maximovev/radio-86rk-sdcard/radio-86rk-SRAM-sdcard-b.png

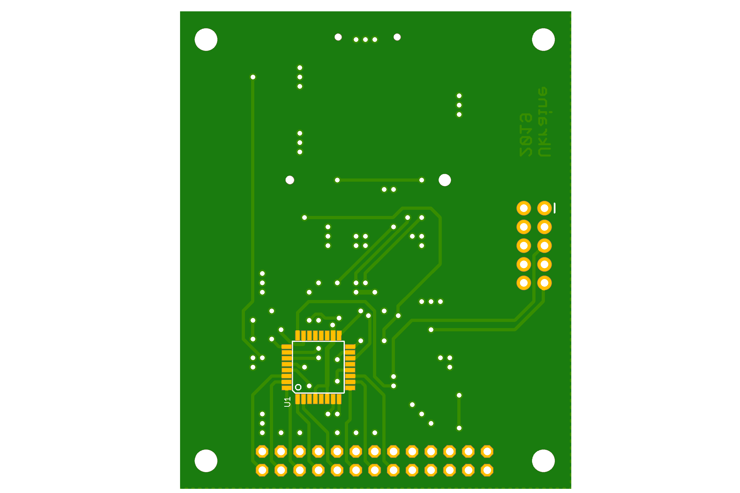
radio-86rk-SRAM-sdcard-b.png
