maximovev/radio-86rk-sdcard/radio-86rk-SRAM-sdcard.png

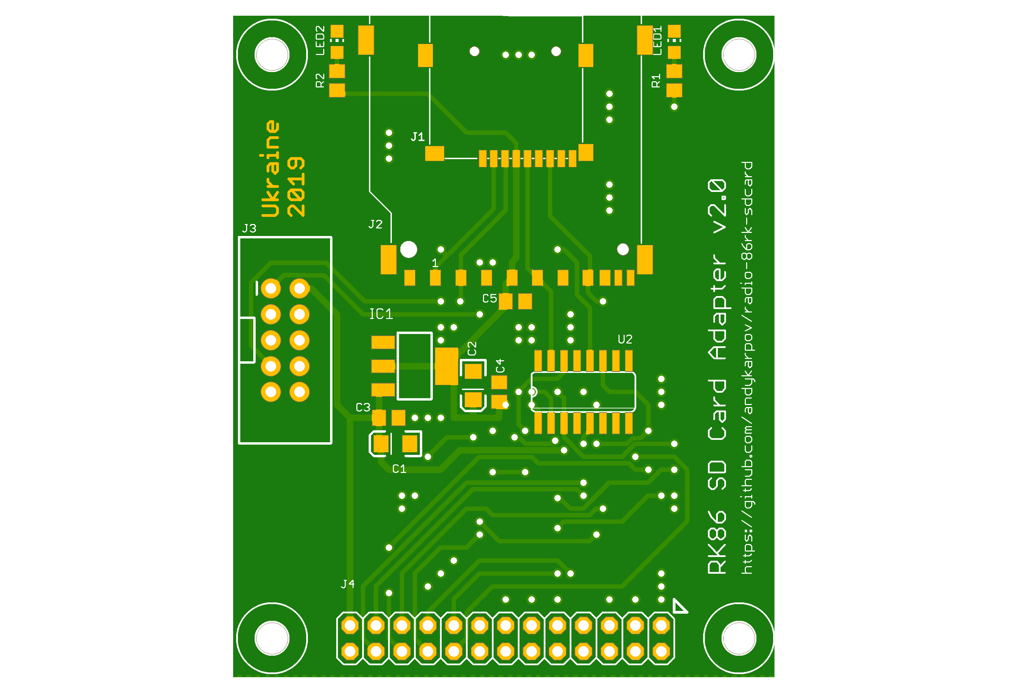
radio-86rk-SRAM-sdcard.png
