maximovev/radio-86rk-sdcard/hw/rk86_sd/rk86_sd.kicad_pcb

## KiCad design hw/rk86_sd/rk86_sd.kicad_pcb (2026-07-14)

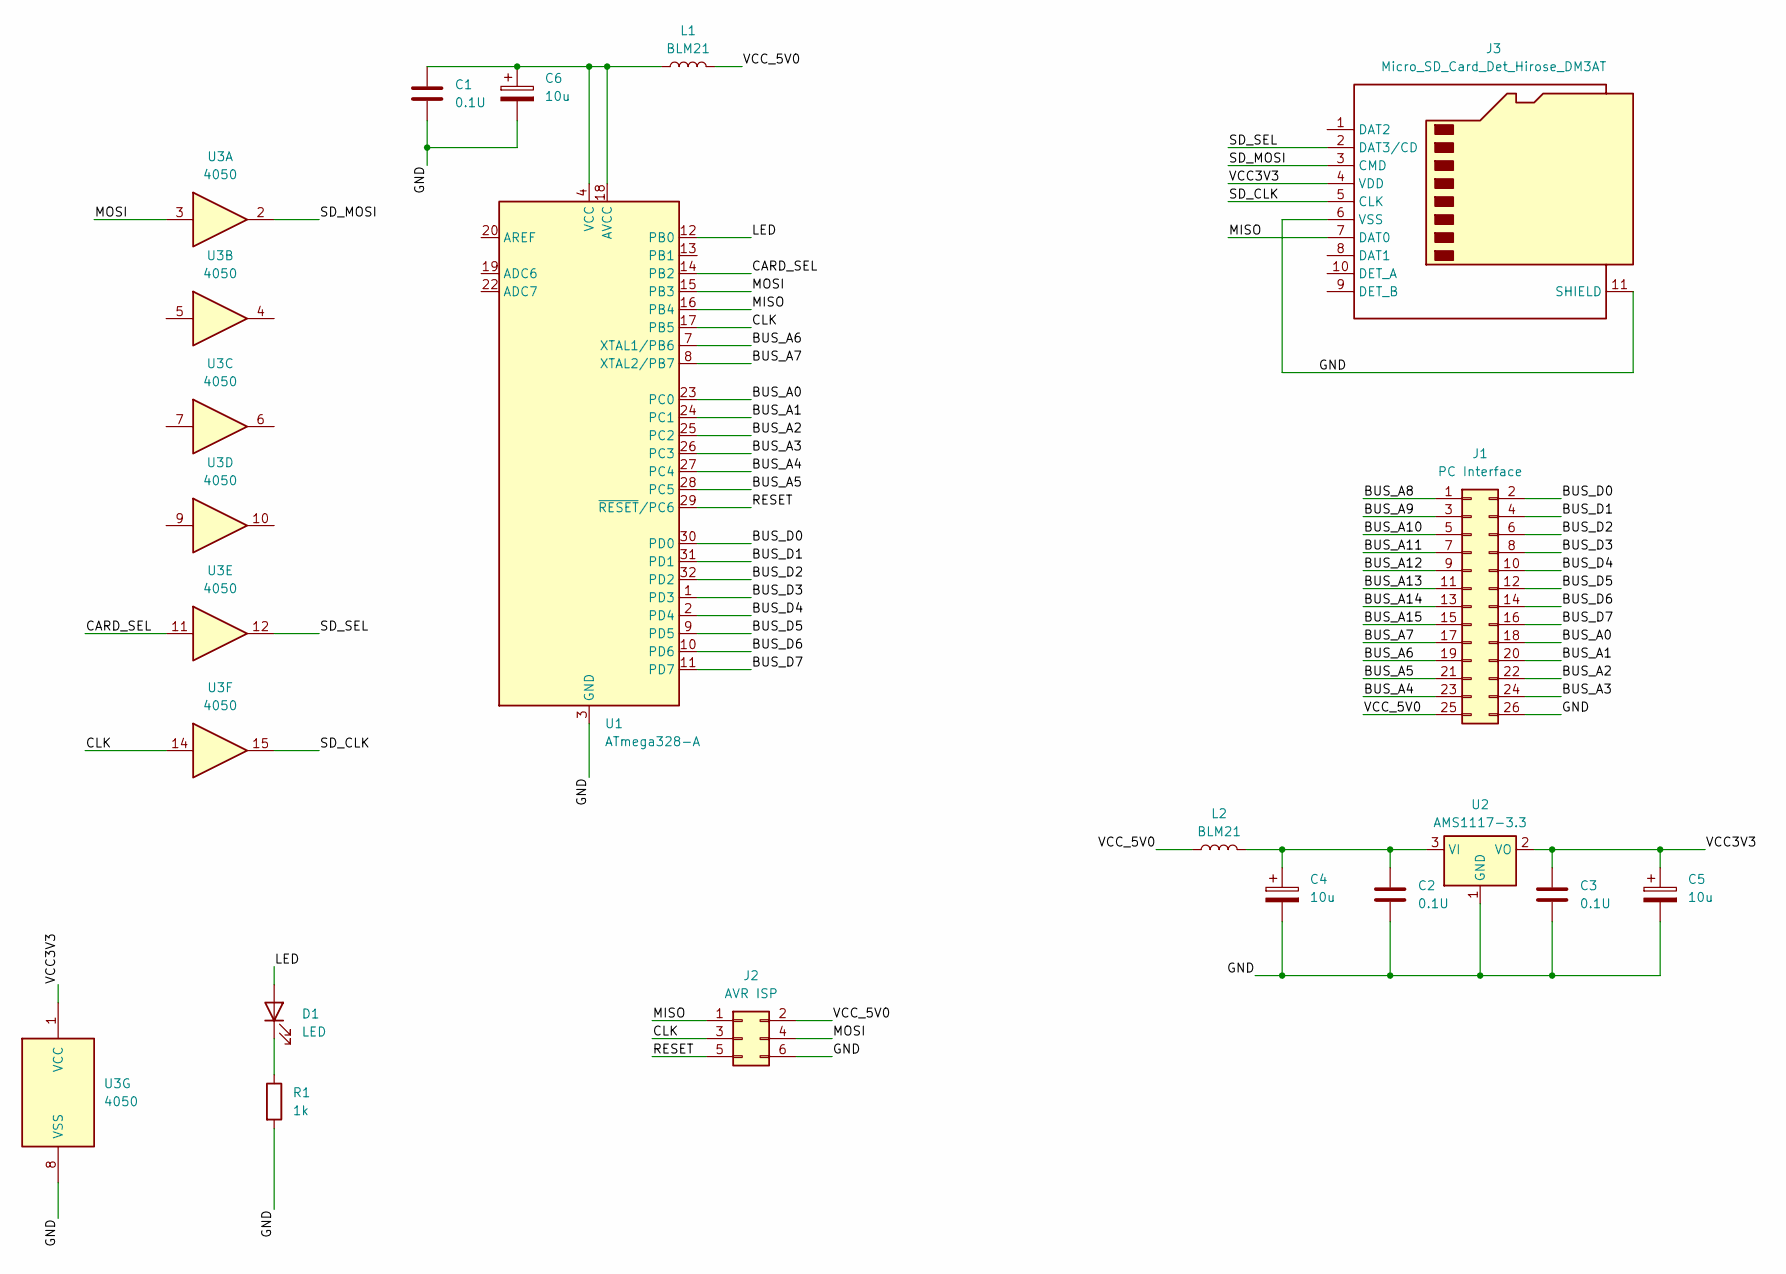
[picture p3: schematic rk86_sd.kicad_sch]

Parts:
C1, C2, C3: 0.1U; C_0805_2012Metric_Pad1.18x1.45mm_HandSolder
C4, C5, C6: 10u; CP_EIA-3528-21_Kemet-B_Pad1.50x2.35mm_HandSolder
D1: LED; LED_0805_2012Metric_Pad1.15x1.40mm_HandSolder
J1: PC Interface; IDC-Header_2x13_P2.54mm_Vertical
J2: AVR ISP; PinHeader_2x03_P2.54mm_Vertical
J3: Micro_SD_Card_Det_Hirose_DM3AT; microSD_HC_Hirose_DM3BT-DSF-PEJS
L1, L2: BLM21; L_0805_2012Metric_Pad1.15x1.40mm_HandSolder
R1: 1k; R_0805_2012Metric_Pad1.20x1.40mm_HandSolder
U1: ATmega328-A; TQFP-32_7x7mm_P0.8mm
U2: AMS1117-3.3; SOT-223-3_TabPin2
U3: 4050; SOIC-16_3.9x9.9mm_P1.27mm

Connections:
/BUS_A0: J1.18, U1.23 (PC0)
/BUS_A1: J1.20, U1.24 (PC1)
/BUS_A2: J1.22, U1.25 (PC2)
/BUS_A3: J1.24, U1.26 (PC3)
/BUS_A4: J1.23, U1.27 (PC4)
/BUS_A5: J1.21, U1.28 (PC5)
/BUS_A6: J1.19, U1.7 (XTAL1/PB6)
/BUS_A7: J1.17, U1.8 (XTAL2/PB7)
/BUS_A8: J1.1
/BUS_A9: J1.3
/BUS_A10: J1.5
/BUS_A11: J1.7
/BUS_A12: J1.9
/BUS_A13: J1.11
/BUS_A14: J1.13
/BUS_A15: J1.15
/BUS_D0: J1.2, U1.30 (PD0)
/BUS_D1: J1.4, U1.31 (PD1)
/BUS_D2: J1.6, U1.32 (PD2)
/BUS_D3: J1.8, U1.1 (PD3)
/BUS_D4: J1.10, U1.2 (PD4)
/BUS_D5: J1.12, U1.9 (PD5)
/BUS_D6: J1.14, U1.10 (PD6)
/BUS_D7: J1.16, U1.11 (PD7)
/CARD_SEL: U1.14 (PB2), U3.11
/CLK: J2.3, U1.17 (PB5), U3.14
/GND: C1.2, C2.2, C3.2, C4.2, C5.2, C6.2, J1.26, J2.6, J3.6 (VSS), J3.11 (SHIELD), R1.2, U1.3 (GND), U1.5 (GND), U1.21 (GND), U2.1 (GND), U3.8 (VSS)
/LED: D1.2 (A), U1.12 (PB0)
/MISO: J2.1, J3.7 (DAT0), U1.16 (PB4)
/MOSI: J2.4, U1.15 (PB3), U3.3
/RESET: J2.5, U1.29 (~RESET/PC6)
/SD_CLK: J3.5 (CLK), U3.15
/SD_MOSI: J3.3 (CMD), U3.2
/SD_SEL: J3.2 (DAT3/CD), U3.12
/VCC3V3: C3.1, C5.1, J3.4 (VDD), U2.2 (VO), U3.1 (VCC)
/VCC_5V0: J1.25, J2.2, L1.2, L2.1
unnamed: D1.1 (K), R1.1
unnamed: C1.1, C6.1, L1.1, U1.4 (VCC), U1.6 (VCC), U1.18 (AVCC)
unnamed: C2.1, C4.1, L2.2, U2.3 (VI)

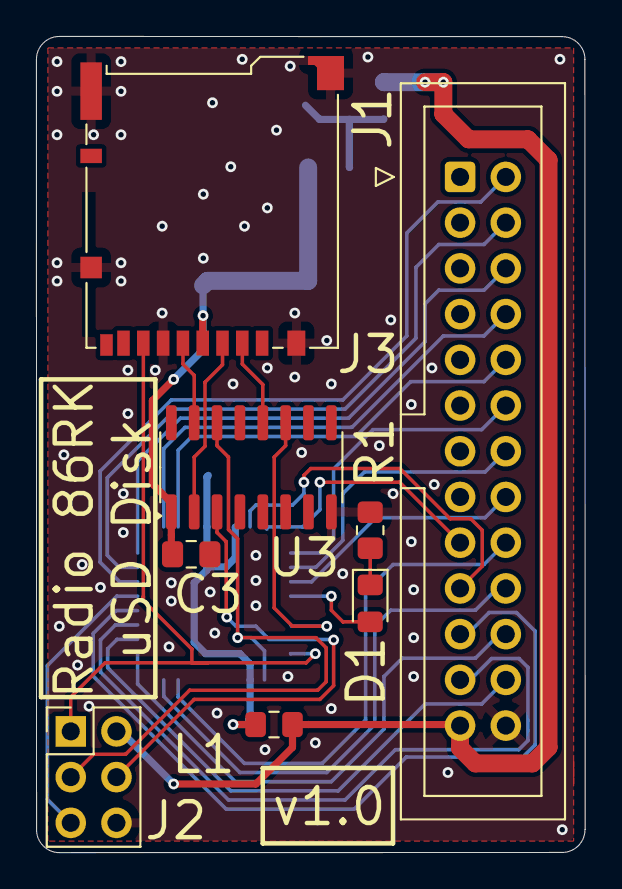
[picture p4: board rk86_sd.kicad_pcb from above]

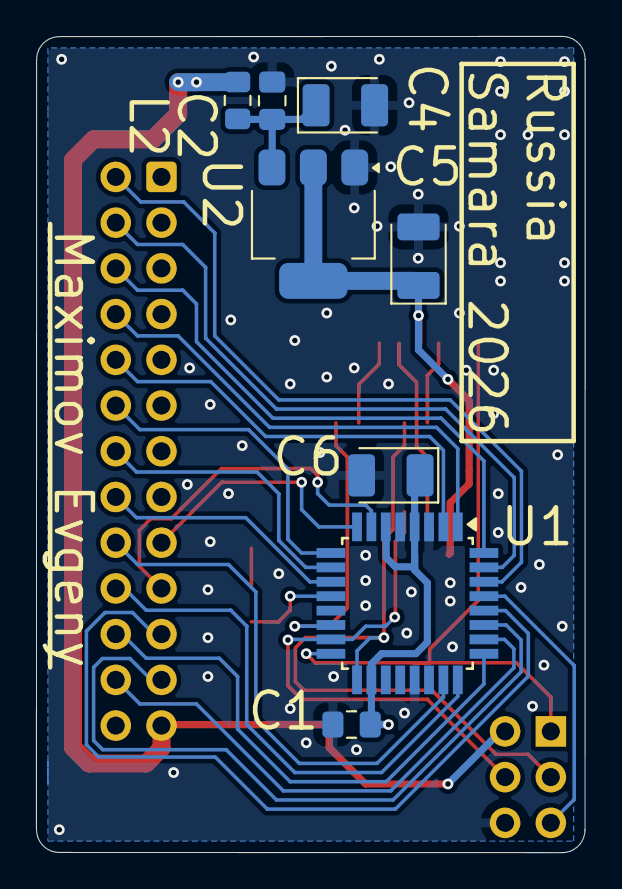
[picture p5: board rk86_sd.kicad_pcb from below]

Board: 2 copper layers, 30.5 x 45.3 mm, 16 parts (8 on the bottom side), 31 nets.
