maximovev/radio-86rk-sdcard/radio-86rk-SRAM-sdcard.brd

## EAGLE design radio-86rk-SRAM-sdcard.brd (2026-04-23)

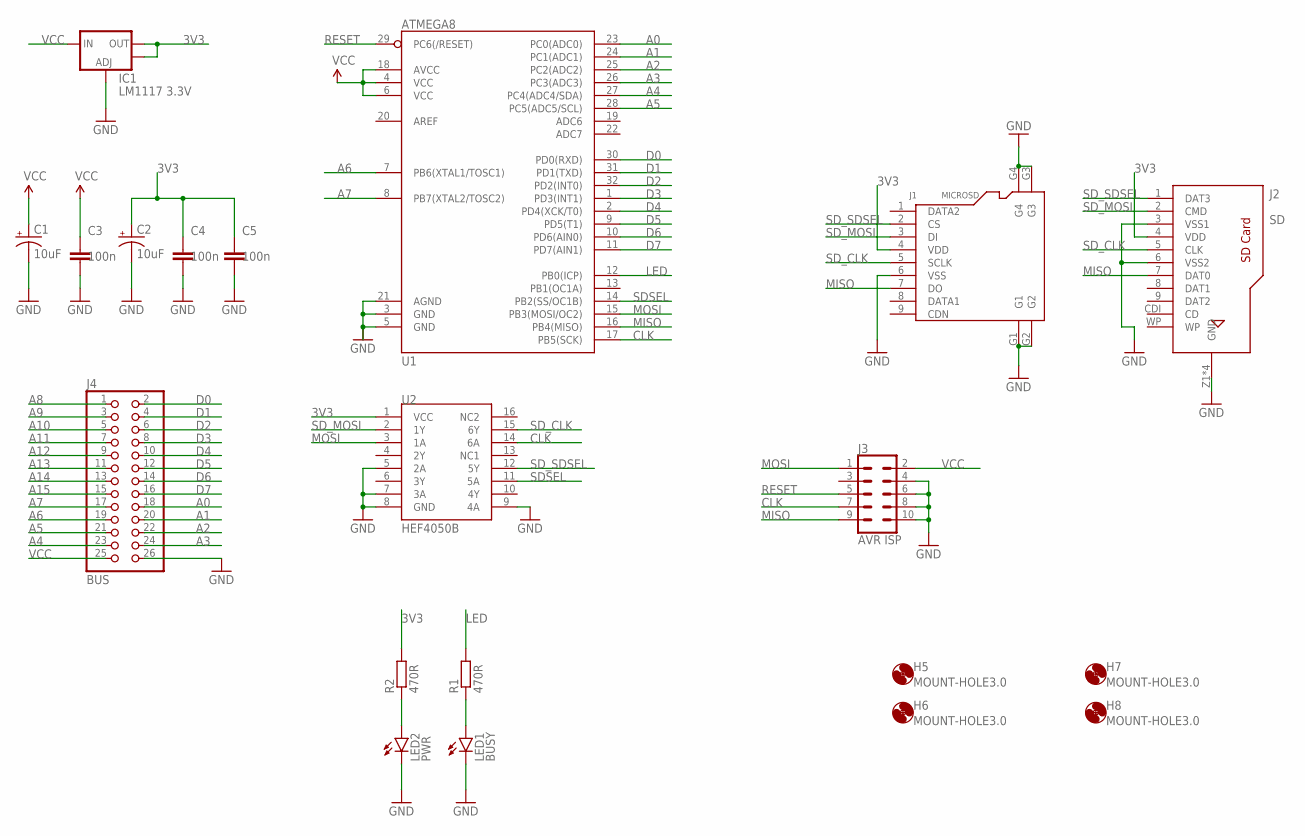
[picture p6: schematic radio-86rk-SRAM-sdcard.sch]

Parts:
C1, C2: 10uF; EIA3216
C3, C4, C5: 100n; C0805
H5, H6, H7, H8: MOUNT-HOLE3.0; 3,0
IC1: LM1117 3.3V; SOT223
J1: MICROSD; MICRO-SD9+4P-SMD-16.1X14.5X1.85MM
J2: SD; 693063010911
J3: AVR ISP; 2X5-SHROUDED_LOCK
J4: BUS; 2X13
LED1: BUSY; CHIP-LED0805
LED2: PWR; CHIP-LED0805
R1, R2: 470R; R0805
U1: ATMEGA8; TQFP32-08
U2: HEF4050B; SO16

Connections:
3V3: C2.A (+), C4.1, C5.1, IC1.2 (OUT), IC1.4 (OUT), J1.4 (VDD), J2.4 (VDD), R2.2, U2.1 (VCC)
A0: J4.18, U1.23 (PC0(ADC0))
A1: J4.20, U1.24 (PC1(ADC1))
A2: J4.22, U1.25 (PC2(ADC2))
A3: J4.24, U1.26 (PC3(ADC3))
A4: J4.23, U1.27 (PC4(ADC4/SDA))
A5: J4.21, U1.28 (PC5(ADC5/SCL))
A6: J4.19, U1.7 (PB6(XTAL1/TOSC1))
A7: J4.17, U1.8 (PB7(XTAL2/TOSC2))
A8: J4.1
A9: J4.3
A10: J4.5
A11: J4.7
A12: J4.9
A13: J4.11
A14: J4.13
A15: J4.15
CLK: J3.7, U1.17 (PB5(SCK)), U2.14 (6A)
D0: J4.2, U1.30 (PD0(RXD))
D1: J4.4, U1.31 (PD1(TXD))
D2: J4.6, U1.32 (PD2(INT0))
D3: J4.8, U1.1 (PD3(INT1))
D4: J4.10, U1.2 (PD4(XCK/T0))
D5: J4.12, U1.9 (PD5(T1))
D6: J4.14, U1.10 (PD6(AIN0))
D7: J4.16, U1.11 (PD7(AIN1))
GND: C1.C (-), C2.C (-), C3.2, C4.2, C5.2, IC1.1 (ADJ), J1.6 (VSS), J1.G1, J1.G2, J1.G3, J1.G4, J2.3 (VSS1), J2.6 (VSS2), J2.Z1 (GND), J2.Z2 (GND), J2.Z3 (GND), J2.Z4 (GND), J3.4, J3.6, J3.8, J3.10, J4.26, LED1.C, LED2.C, U1.3 (GND), U1.5 (GND), U1.21 (AGND), U2.5 (2A), U2.7 (3A), U2.8 (GND), U2.9 (4A)
LED: R1.2, U1.12 (PB0(ICP))
MISO: J1.7 (DO), J2.7 (DAT0), J3.9, U1.16 (PB4(MISO))
MOSI: J3.1, U1.15 (PB3(MOSI/OC2)), U2.3 (1A)
unnamed: LED1.A, R1.1
unnamed: LED2.A, R2.1
RESET: J3.5, U1.29 (PC6(/RESET))
SDSEL: U1.14 (PB2(SS/OC1B)), U2.11 (5A)
SD_CLK: J1.5 (SCLK), J2.5 (CLK), U2.15 (6Y)
SD_MOSI: J1.3 (DI), J2.2 (CMD), U2.2 (1Y)
SD_SDSEL: J1.2 (CS), J2.1 (DAT3), U2.12 (5Y)
VCC: C1.A (+), C3.1, IC1.3 (IN), J3.2, J4.25, U1.4 (VCC), U1.6 (VCC), U1.18 (AVCC)

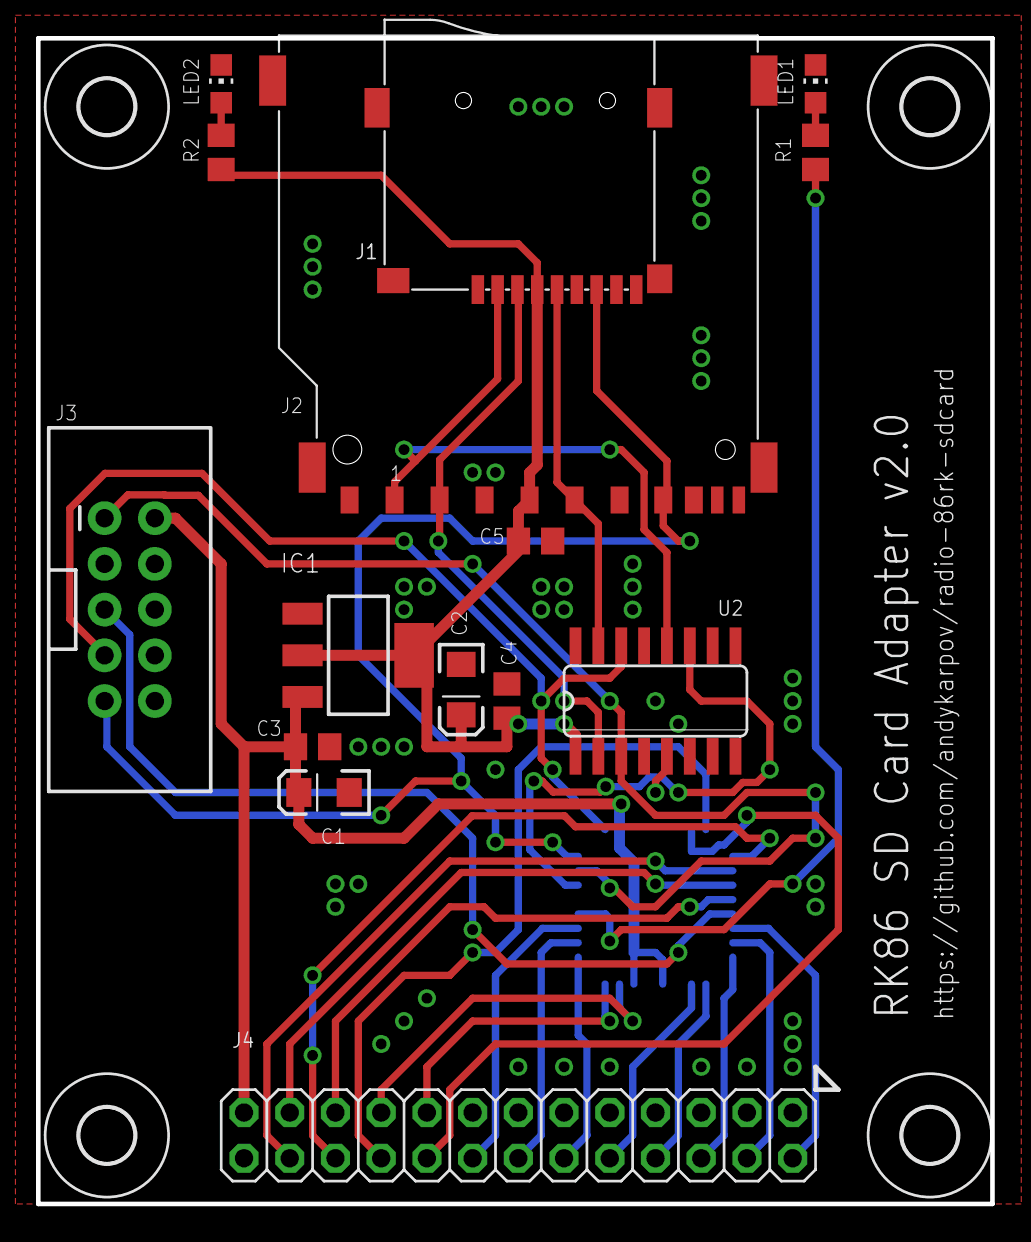
[picture p7: board radio-86rk-SRAM-sdcard.brd from above]

Board: 2 copper layers, 53.0 x 64.8 mm, 20 parts (1 on the bottom side), 30 nets.
