maximovev/radio-86rk-sdcard/old/firmware/src/atmega328p/86rksd.c

// SD Controller for Computer "Radio 86RK" / "Apogee BK01"
// (c) 10-05-2014 vinxru (aleksey.f.morozov@gmail.com)

//#include <stdafx.h>

#define F_CPU 8000000UL        //freq 8 MHz

#include "common.h"
#include <string.h>
#include "sd.h"
#include "fs.h"
#include "proto.h"

#ifndef X86_DEBUG
#include <delay.h>
#endif

#define O_OPEN   0
#define O_CREATE 1
#define O_MKDIR  2
#define O_DELETE 100
#define O_SWAP   101

#define ERR_START       0x40
#define ERR_WAIT        0x41
#define ERR_OK_DISK         0x42
#define ERR_OK_CMD          0x43
#define ERR_OK_READ         0x44
#define ERR_OK_ENTRY        0x45
#define ERR_OK_WRITE        0x46
#define ERR_OK_RKS          0x47
#define ERR_READ_BLOCK      0x4F

BYTE buf[512];
BYTE rom[128];

/*******************************************************************************
* Для удобства                                                                 *
*******************************************************************************/

void recvBin(BYTE* d, WORD l) {
  for(; l; --l) {
    *d++ = wrecv();
  }  
}

void recvString() {
  BYTE c;
  BYTE* p = buf;       
  do {
    c = wrecv();
    if(p != buf + FS_MAXFILE) *p++ = c; else lastError = ERR_RECV_STRING;
  } while(c);
}

void sendBin(BYTE* p, WORD l) {
  for(; l; l--)
    send(*p++);
}

void sendBinf(flash BYTE* d, BYTE l) {
  for(; l; --l)
    send(*d++);
}

/*******************************************************************************
* Отправка всех блоков файла                                                   *
*******************************************************************************/

WORD readLength;

void readInt(char rks) { 
  WORD readedLength, lengthFromFile;        
  BYTE tmp;
  BYTE* wptr;

  while(readLength) { 
    // Расчет длины блока (выравниваем чтение на сектор)
    if(fs_tell()) return;
    readedLength = 512 - (fs_tmp % 512);
    if(readedLength > readLength) readedLength = readLength;

    // Уменьшаем счетчик
    readLength -= readedLength;

    // Читаем блок
    if(fs_read0(buf, readedLength)) return;

    // Заголовок RKS файла
    wptr = buf;
    if(rks) { // Если rks=1, перед вызовом надо проверить, что бы readLength>4 и fs_file.ptr=0, иначе может быть злостный сбой
      rks = 0;
      
      // У апогея числа перепутаны
      tmp=buf[0], buf[0]=buf[1]; buf[1]=tmp;
      tmp=buf[2], buf[2]=buf[3]; buf[3]=tmp;

      // Посылаем адрес загрузки
      send(ERR_OK_RKS);
      sendBin(buf, 2);    
      send(ERR_WAIT);

      // Корректируем указатели
      wptr += 4;
      readedLength -= 4;

      // Длина из файла
      lengthFromFile = *(WORD*)(buf+2) - *(WORD*)(buf) + 1;

      // Корректируем длину  
      if(readedLength > lengthFromFile) {
        readedLength = lengthFromFile;
      } else {          
        lengthFromFile -= readedLength;
        if(readLength > lengthFromFile) lengthFromFile = readedLength;
      }
    }  

    // Отправляем блок
    send(ERR_READ_BLOCK);    
    sendBin((BYTE*)&readedLength, 2);
    sendBin(wptr, readedLength);
    send(ERR_WAIT);
  }

  // Если все ОК
  if(!lastError) lastError = ERR_OK_READ;
}

/*******************************************************************************
* Версия команд контроллера                                                    *
*******************************************************************************/

void cmd_ver() {
  sendStart(1);
    
  // Версия + Производитель
  sendBinf("V1.0 10-05-2014 ", 16);
              //0123456789ABCDEF
}

/*******************************************************************************
* BOOT / EXEC                                                                  *
*******************************************************************************/

void cmd_boot_exec() {
  // Файл по умолчанию
  if(buf[0]==0) strcpyf(buf, "boot/sdbios.rk");      

  // Открываем файл
  if(fs_open()) return;
  
  // Максимальный размер файла
  readLength = 0xFFFF;  
  if(fs_getfilesize()) return;
  if(readLength > fs_tmp) readLength = (WORD)fs_tmp;

  // Файлы RK должны быть длиной >4 байт. Мы заносим в readLength = 0 и программа
  // получает ERR_OK. Но так как она ждем ERR_OK_RKS, это будет ошибкой 
  if(readLength < 4) readLength = 0;

  readInt(/*rks*/1);  
}

void cmd_boot() { 
  sendStart(ERR_WAIT);
  buf[0] = 0;
  cmd_boot_exec();  
}

void cmd_exec() {     
  // Прием имени файла
  recvString();

  // Режим передачи и подтверждение
  sendStart(ERR_WAIT);
  if(lastError) return; // Переполнение строки
  
  cmd_boot_exec();    
}

/*******************************************************************************
* Начать/продолжить посик файлов в папке                                       *
*******************************************************************************/

typedef struct {
    char    fname[11];    // File name
    BYTE    fattrib;    // Attribute
    DWORD   fsize;        // File size
    union {
      struct {
        WORD    ftime;        // Last modified time
        WORD    fdate;        // Last modified date 
      };
      DWORD ftimedate;
    };
} FILINFO2;

void cmd_find() {
  WORD n;
  FILINFO2 info;              
  
  // Принимаем путь
  recvString();

  // Принимаем макс кол-во элементов
  recvBin((BYTE*)&n, 2);

  // Режим передачи и подтверждение
  sendStart(ERR_WAIT);
  if(lastError) return;

  // Открываем папку
  if(buf[0] != ':') {
    if(fs_opendir()) return;
  }

  for(; n; --n) {
    /* Читаем очереной описатель */
    if(fs_readdir()) return;

    /* Конец */
    if(FS_DIRENTRY[0] == 0) {
      lastError = ERR_OK_CMD;
      return;
    }

    /* Сжимаем ответ для компьютера */
    memcpy(info.fname, FS_DIRENTRY+DIR_Name, 12);
    memcpy(&info.fsize, FS_DIRENTRY+DIR_FileSize, 4);
    memcpy(&info.ftimedate, FS_DIRENTRY+DIR_WrtTime, 4);
    //memcpy(memcpy(memcpy(info.fname, FS_DIRENTRY+DIR_Name, 12, FS_DIRENTRY+DIR_FileSize, 4), FS_DIRENTRY+DIR_WrtTime, 4);

    /* Отправляем */
    send(ERR_OK_ENTRY);
    sendBin((BYTE*)&info, sizeof(info));
    send(ERR_WAIT);
  }

  /* Ограничение по размеру */  
  lastError = ERR_MAX_FILES; /*! Надо опеределать, что бы не было ложных ошибок */
}

/*******************************************************************************
* Открыть/создать файл/папку                                                   *
*******************************************************************************/

void cmd_open() {
  BYTE mode;
 
  /* Принимаем режим */
  mode = wrecv();    

  // Принимаем имя файла
  recvString();

  // Режим передачи и подтверждение
  sendStart(ERR_WAIT);

  // Открываем/создаем файл/папку
  if(mode == O_SWAP) {
    fs_swap();
  } else
  if(mode == O_DELETE) {
    fs_delete();
  } else
  if(mode == O_OPEN) {
    fs_open();
  } else 
  if(mode < 3) {
    fs_open0(mode);
  } else {
    lastError = ERR_INVALID_COMMAND;
  }

  // Ок
  if(!lastError) lastError = ERR_OK_CMD;
}

/*******************************************************************************
* Переместить файл/папку                                                       *
*******************************************************************************/

void cmd_move() {
  recvString();
  sendStart(ERR_WAIT);
  fs_openany();
  sendStart(ERR_OK_WRITE);
  recvStart();
  recvString();
  sendStart(ERR_WAIT);
  if(!lastError) fs_move0();
  if(!lastError) lastError = ERR_OK_CMD;
}

/*******************************************************************************
* Установить/прочитать указатель чтения                                        *
*******************************************************************************/

void cmd_lseek() {
  BYTE mode;
  DWORD off;

  // Принимаем режим и смещение
  mode = wrecv();    
  recvBin((BYTE*)&off, 4);    

  // Режим передачи и подтверждение
  sendStart(ERR_WAIT);

  // Размер файла
  if(mode==100) {
    if(fs_getfilesize()) return;
  }

  // Размер диска  
  else if(mode==101) {
    if(fs_gettotal()) return;
  }
 
  // Свободное место на диске
  else if(mode==102) {
    if(fs_getfree()) return;
  }

  else {
    /* Устаналиваем смещение. fs_tmp сохраняется */
    if(fs_lseek(off, mode)) return;
  }

  // Передаем результат
  send(ERR_OK_CMD);
  sendBin((BYTE*)&fs_tmp, 4);  
  lastError = 0; // На всякий случай, результат уже передан
}

/*******************************************************************************
* Прочитать из файла                                                           *
*******************************************************************************/

void cmd_read() {
  DWORD s;

  // Длина
  recvBin((BYTE*)&readLength, 2);

  // Режим передачи и подтверждение
  sendStart(ERR_WAIT);

  // Ограничиваем длину длиной файла
  if(fs_getfilesize()) return;
  s = fs_tmp; 
  if(fs_tell()) return;
  s -= fs_tmp;
                    
  if(readLength > s)
    readLength = (WORD)s;

  // Отправляем все блоки файла
  readInt(/*rks*/0);
}

/*******************************************************************************
* Записать данные в файл                                                       *
*******************************************************************************/

void cmd_write() {
  // Аргументы
  recvBin((BYTE*)&fs_wtotal, 2); 

  // Ответ
  sendStart(ERR_WAIT);
           
  // Конец файла
  if(fs_wtotal==0) {
    fs_write_eof();
    lastError = ERR_OK_CMD;
    return;
  }
  
  // Запись данных
  do {
    if(fs_write_start()) return;

    // Принимаем от компьюетра блок данных
    send(ERR_OK_WRITE);
    sendBin((BYTE*)&fs_file_wlen, 2);
    recvStart();    
    recvBin(fs_file_wbuf, fs_file_wlen);
    sendStart(ERR_WAIT);

    if(fs_write_end()) return;
  } while(fs_wtotal);

  lastError = ERR_OK_CMD;
}

/*******************************************************************************
* Главная процедура                                                            *
*******************************************************************************/

void error() {
  for(;;) {
    PORTB.0 = 1;
    delay_ms(100);
    PORTB.0 = 0;
    delay_ms(100);
  }
}

void main() {
  BYTE c, d, i;
    
  DATA_OUT            // Шина данных (DDRD)
  DDRC  = 0b00000000; // Шина адреса
  DDRB  = 0b00101101; // Шина адреса, карта и светодиод
  PORTB = 0b00010001; // Подтягивающий резистор на MISO и светодиод  

  // Пауза, пока не стабилизируется питание
  delay_ms(500);

  // Запуск файловой системы
  if(fs_init()) error();
  strcpyf(buf, "boot/boot.rk");
  if(fs_open()) error();
  if(fs_getfilesize()) error();
  if(fs_tmp < 7) error();
  if(fs_tmp > 128) error();
  if(fs_read0(rom, (WORD)fs_tmp)) error();  
                   
  delay_ms(100);
  
  // Гасим светодиод
  PORTB.0 = 0;
  
  while(1) {
    // Эмуляция ПЗУ
#asm
.EQU PIND  = $9
.EQU DDRD  = 0xa
.EQU PORTD = 0xb
.EQU PINC  = $6
.EQU DDRC  = $7
.EQU PORTC = $8
.EQU PINB  = $3
.EQU DDRB  = $4
.EQU PORTB = $5
.EQU ROM   = 2

.macro GET_ADDR
        IN   R30, PINC         ; Младшие 6 бит
        ANDI R30, 0x3F
        IN   R26, PINB         ; Старший бит
        ANDI R26, 0x40
        OR   R30, R26
.endmacro

.macro ROM_EMU
        LD   R30, Z
        OUT  PORTD, R30
        ;NOP
        ;NOP
        ;NOP
        ;NOP
.endmacro

        ; Устаналвиается один раз для ROM_EMU
        PUSH R26
        PUSH R30
        PUSH R31
        LDI  R31, ROM                    

        ; Получаем адрес
        GET_ADDR
        
        ; Эмулируем ПЗУ          
LOOP0:  ROM_EMU
                  
        ; Получаем адрес и если это не 0x44, то переходим в начало
        GET_ADDR
        CPI  R30, 0x44
        BRNE LOOP0
        
        ; Эмулируем ПЗУ (0x44-ый адрес)
        ROM_EMU
                
        ; Получаем адрес и если это все еще 0x44, то ждем.        
        ; Если это не 0x40, то переходим в начало         
LOOP1:  GET_ADDR
        CPI  R30, 0x44
        BREQ LOOP1
        CPI  R30, 0x40
        BRNE LOOP0
            
        ; Эмулируем ПЗУ (0x40-ый адрес)          
        ROM_EMU
        
        ; Получаем адрес и если это все еще 0x40, то ждем.        
        ; Если это не 0, то переходим в начало
LOOP2:  GET_ADDR
        CPI  R30, 0x40
        BREQ LOOP2
        CPI  R30, 0
        BRNE LOOP0                  

        POP R31
        POP R30
        POP R26
#endasm          

    // Зажигаем светодиод
    PORTB.0 = 1;

    // Проверяем наличие карты
    sendStart(ERR_START);
    send(ERR_WAIT);
    if(fs_check()) {
      send(ERR_DISK_ERR);
    } else {
      send(ERR_OK_DISK);
      recvStart();
      c = wrecv();
      
      // Сбрасываем ошибку
      lastError = 0;
    
      // Принимаем аргументы 
      switch(c) {
        case 0:  cmd_boot();         break; 
        case 1:  cmd_ver();          break;
        case 2:  cmd_exec();         break; 
        case 3:  cmd_find();         break;
        case 4:  cmd_open();         break;     
        case 5:  cmd_lseek();        break;     
        case 6:  cmd_read();         break;     
        case 7:  cmd_write();        break; 
        case 8:  cmd_move();         break;
        default: lastError = ERR_INVALID_COMMAND;      
      }
    
      // Вывод ошибки
      if(lastError) sendStart(lastError);
    }

    // Порт рабоатет на выход
    wait();
    DATA_OUT
    
    // Гасим светодиод
    PORTB.0 = 0;
  } 
}
