maximovev/radio-86rk-sdcard/(commit log)

2026-04-23 Recovered v2.0 of the PCB
    [radio-86rk-SRAM-sdcard.brd, radio-86rk-SRAM-sdcard.sch]
2026-07-14 new pcb ver
    [radio-86rk-SRAM-sdcard.GBL, radio-86rk-SRAM-sdcard.GBO, radio-86rk-SRAM-sdcard.GBP, radio-86rk-SRAM-sdcard.GBS, radio-86rk-SRAM-sdcard.GTL, radio-86rk-SRAM-sdcard.GTO, radio-86rk-SRAM-sdcard.GTP, radio-86rk-SRAM-sdcard.GTS]
2026-07-14 small pcb edition
    [rk86_sd.kicad_pcb, rk86_sd.kicad_sch]
